Tires/high-side-switch/pics/IMG_20220913_173659.jpg

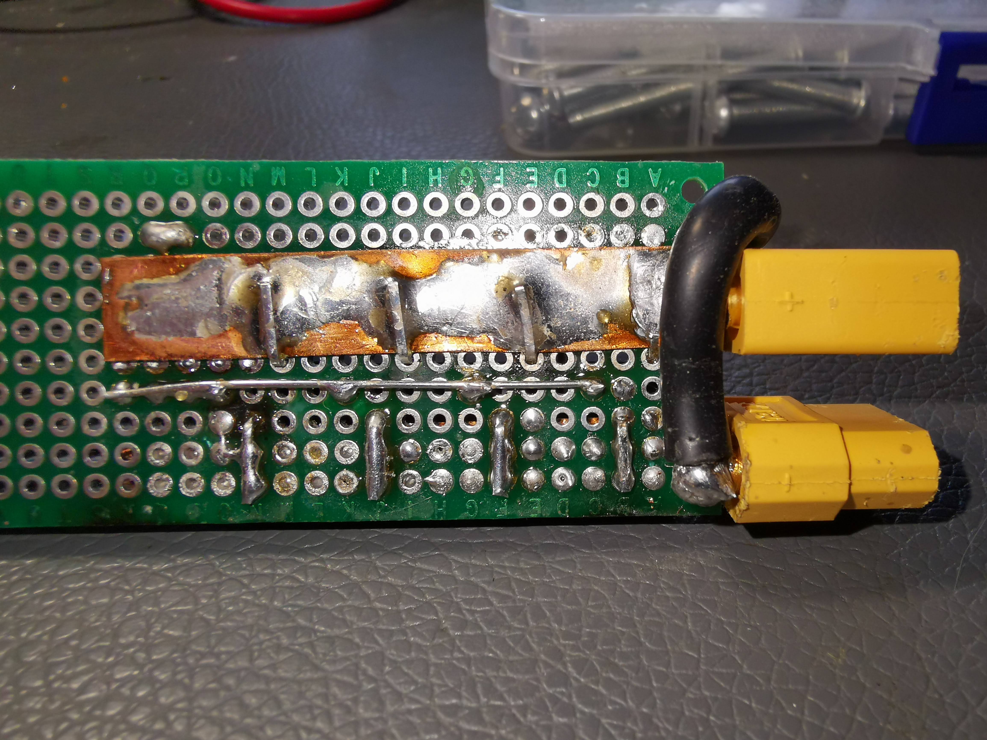
pics/IMG_20220913_173659.jpg
