Tires/high-side-switch/pics/IMG_20220913_173714.jpg

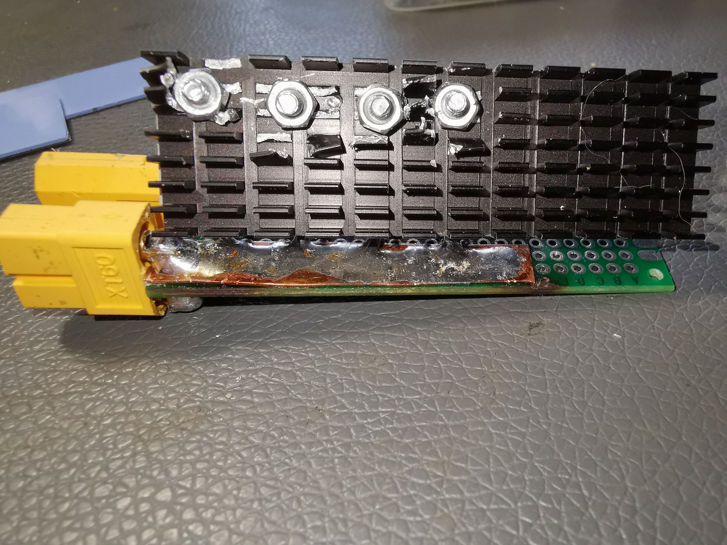
pics/IMG_20220913_173714.jpg
