Tires/high-side-switch/pics/IMG_20220913_173633.jpg

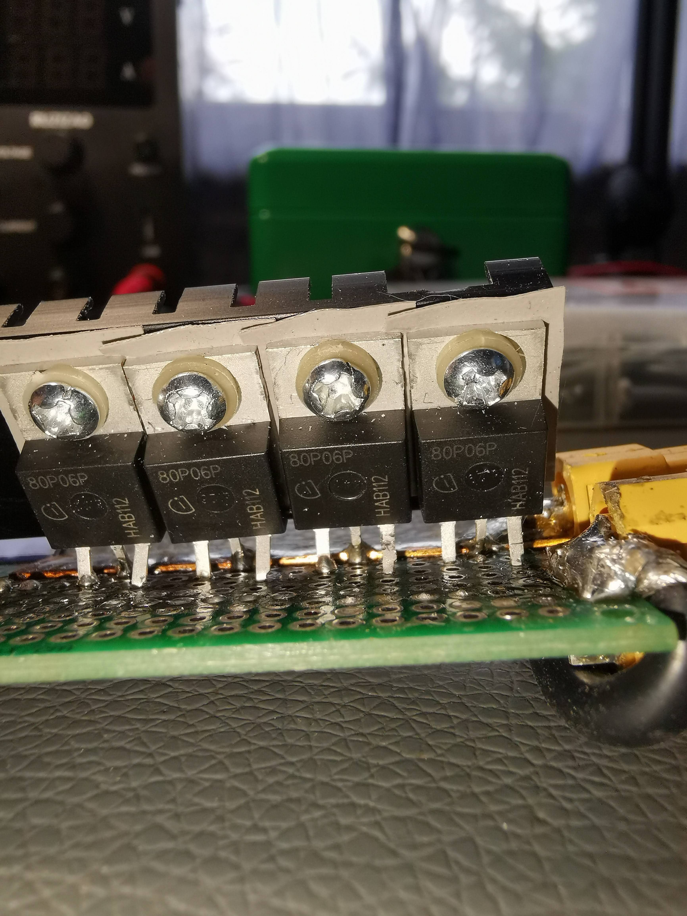
pics/IMG_20220913_173633.jpg
