Tires/high-side-switch/pics/P-Switch 1.002a.png

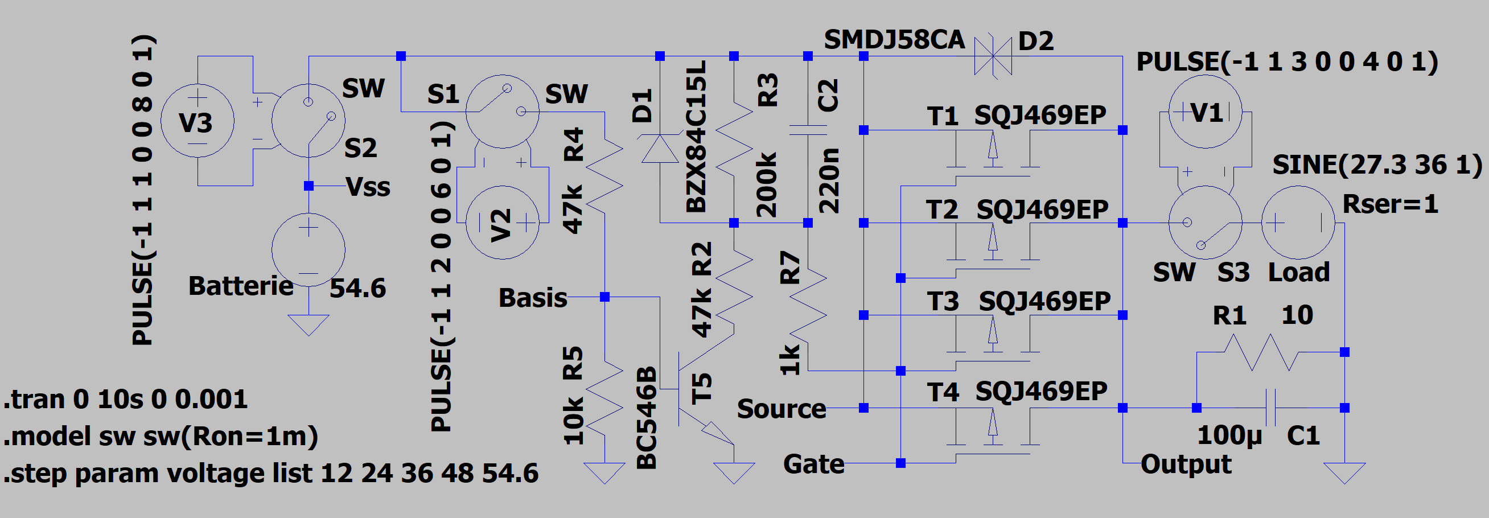
pics/P-Switch 1.002a.png
