Tires/high-side-switch/pics/P-Switch 1.002b.png

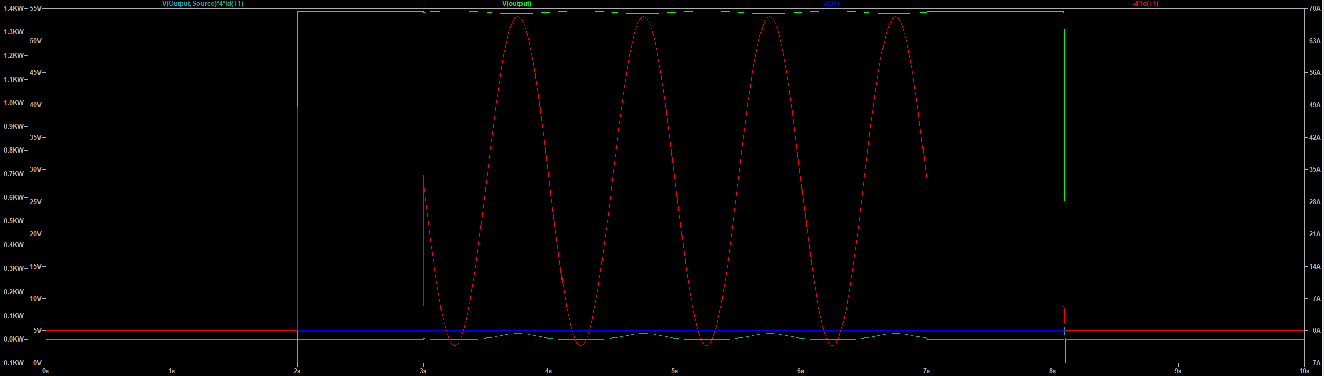
pics/P-Switch 1.002b.png
