Tires/high-side-switch/src/P-Switch 1.002.asc

Batterie: voltage; 54.6
C1: cap; 100µ
C2: cap; 220n
D1: zener; BZX84C15L
D2: TVS_Littelfuse_BI
Load: voltage; SINE(27.3 36 1); Rser=1
R1: res; 10
R2: res; 47k
R3: res; 200k
R4: res; 47k
R5: res; 10k
R7: res; 1k
S1: sw
S2: sw
S3: sw
T1: pmos; SQJ469EP
T2: pmos; SQJ469EP
T3: pmos; SQJ469EP
T4: pmos; SQJ469EP
T5: npn; BC546B
V1: voltage; PULSE(-1 1 3 0 0 4 0 1)
V2: voltage; PULSE(-1 1 2 0 0 6 0 1)
V3: voltage; PULSE(-1 1 1 0 0 8 0 1)
Named nets: 0, Output, Basis, Gate, Source, Vss
.tran 0 10s 0 0.001
.model sw sw(Ron=1m)
.step param voltage list 12 24 36 48 54.6
